FATCullen/Fumehood/fume_hood/Trigger.SLDPRT

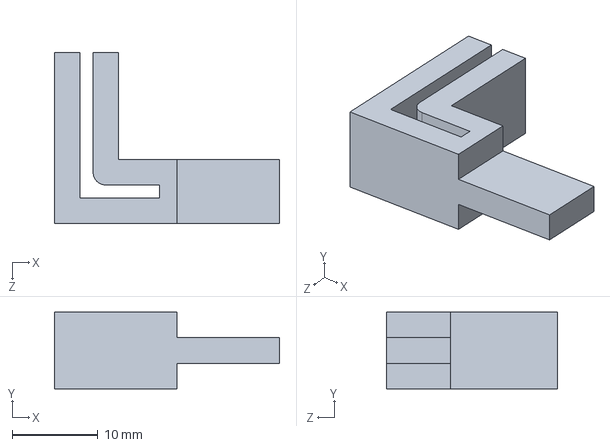
[picture p1: CAD file, 2023-09-02]
fume_hood/Trigger.SLDPRT
26.3 x 9.00 x 20.0 mm
