FATCullen/Fumehood/fume_hood/Enclosure3.SLDPRT

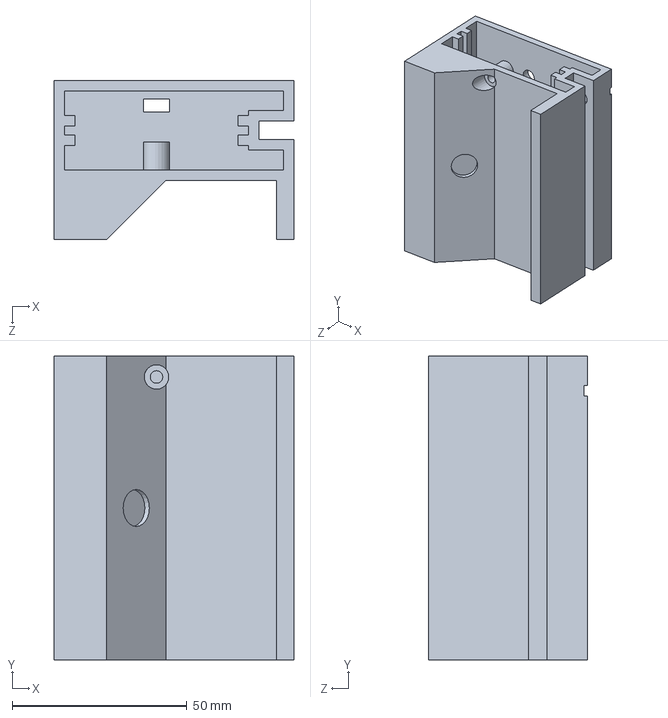
[picture p2: CAD file, 2023-09-02]
fume_hood/Enclosure3.SLDPRT
68.6 x 87.0 x 45.6 mm
