FATCullen/Fumehood/fume_hood/Lid.SLDPRT

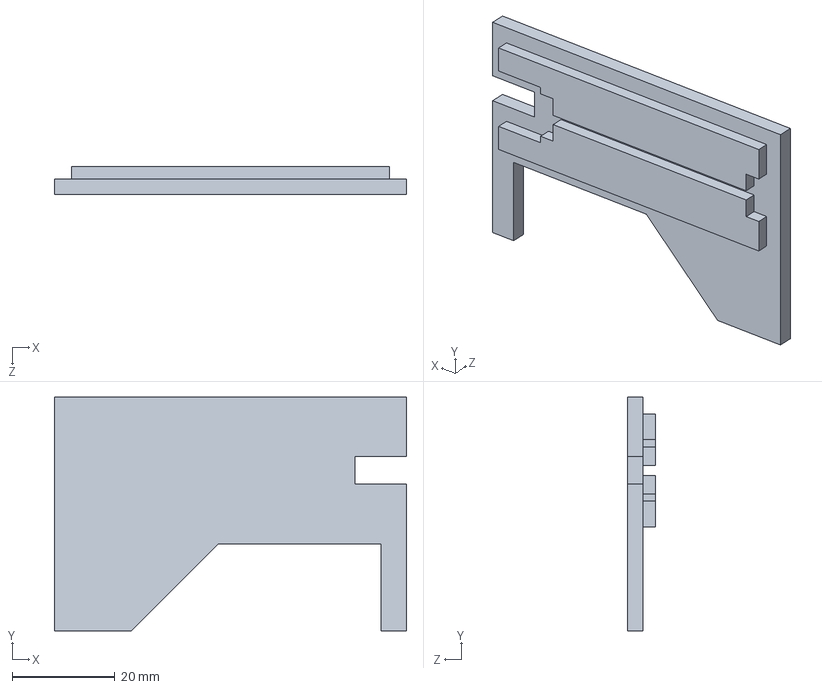
[picture p3: CAD file, 2023-09-02]
fume_hood/Lid.SLDPRT
68.6 x 45.6 x 5.40 mm
